SystemsCyber/CANWatermarking/provisioningApp/SelectProvisionButton.png

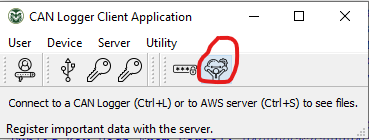
provisioningApp/SelectProvisionButton.png
