SystemsCyber/CANWatermarking/docs/SettingsExperiment.xlsx

CMAC Performance Results |  |  |  |  |  |  |  | CMAC_SEND_TIME_MS 1000
Run | False Positives 0x00 | False Positives 0x0B | Count 0x00 | Count 0x0B |  | Busload | CANGEN gap | CMAC_PAD_TIME | MIN_CAN_TIME_SPACING | NUM_TX_MAILBOXES | NUM_RX_MAILBOXES | FIFO_ENABLED | SEND_DURING_PAUSE | msg.seq = 1 | Notes
1 | 146 |  |  |  |  | 27 | off | 500 | 800 | 32 | 32 | 1 | 0
2 | None |  |  |  |  | 19 | off | 500 | 1000 | 1 | 32 | 1 | 1
3 | 1 |  | 727 |  | 13.75515818 | 19 | off | 500 | 1000 | 2 | 32 | 1 | 1
4 | 1 |  | 291 |  | 34.36426117 | 20 | off | 500 | 1000 | 2 | 32 | 1 | 1
5 | 1 |  | 143 |  | 69.93006993 | 20 | off | 500 | 1000 | 2 | 32 | 0 | 1
6 | 1 |  | 2376 |  | 4.208754209 | 19 | off | 1000 | 1000 | 2 | 32 | 0 | 1
7 | 1 |  | 504 |  | 19.84126984 | 28 | off | 1000 | 500 | 2 | 32 | 1 | 1
8 | 1 |  | 114 |  | 87.71929825 | 28 | off | 500 | 1000 | 2 | 32 | 0 | 0
9 | 5 | 0 | 12965 | 13266 | 1.906141588 | 20 | off | 1000 | 1000 | 2 | 32 | 1 | 1
10 | 14 | 7 | 1529 | 1529 | 68.67233486 | 28 | off | 1000 | 500 | 2 | 32 | 1 | 1 |  | Missed one at the beginning
11 | 12 | 0 | 6821 | 6832 | 8.789277082 | 27 | off | 1000 | 800 | 2 | 32 | 1 | 1
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
