SystemsCyber/CANWatermarking/docs/Schematics for Secure Gateway Prototype.pdf

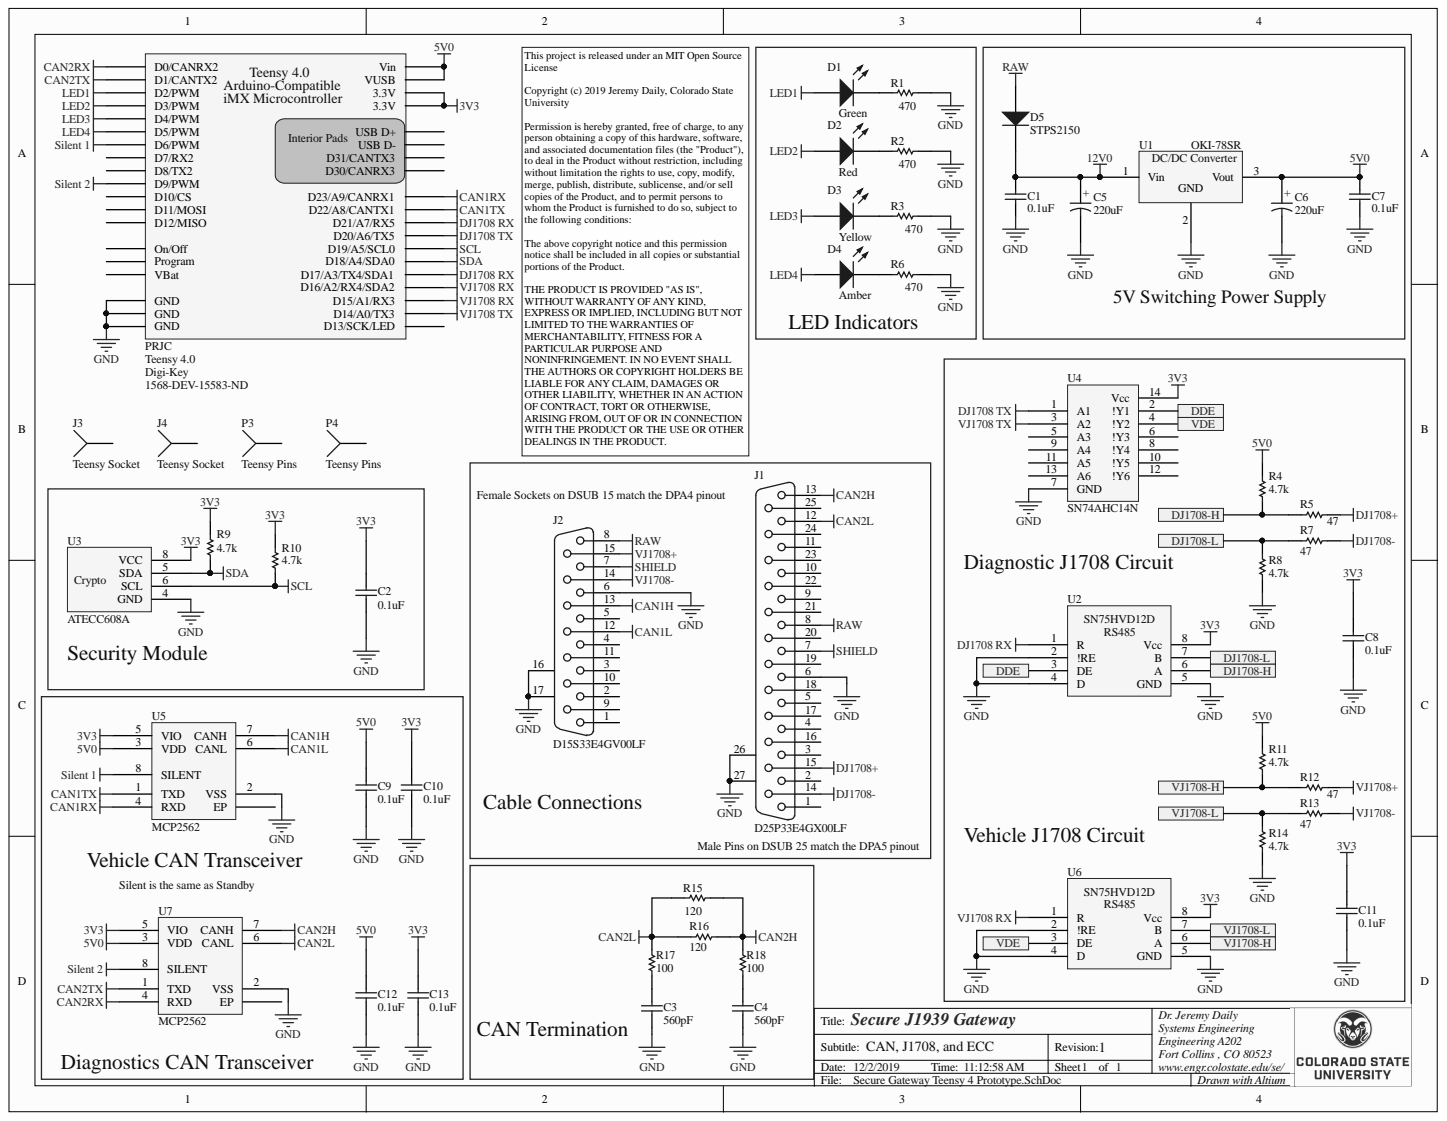
[picture p2: page 1]

This project is released under an MIT Open Source
License

Copyright (c) 2019 Jeremy Daily, Colorado State
University

Permission is hereby granted, free of charge, to any
person obtaining a copy of this hardware, software,
and associated documentation files (the "Product"),
to deal in the Product without restriction, including
without limitation the rights to use, copy, modify,
merge, publish, distribute, sublicense, and/or sell
copies of the Product, and to permit persons to
whom the Product is furnished to do so, subject to
the following conditions:

The above copyright notice and this permission
notice shall be included in all copies or substantial
portions of the Product.

THE PRODUCT IS PROVIDED "AS IS",
WITHOUT WARRANTY OF ANY KIND,
EXPRESS OR IMPLIED, INCLUDING BUT NOT
LIMITED TO THE WARRANTIES OF
MERCHANTABILITY, FITNESS FOR A
PARTICULAR PURPOSE AND
NONINFRINGEMENT. IN NO EVENT SHALL
THE AUTHORS OR COPYRIGHT HOLDERS BE
LIABLE FOR ANY CLAIM, DAMAGES OR
OTHER LIABILITY, WHETHER IN AN ACTION
OF CONTRACT, TORT OR OTHERWISE,
ARISING FROM, OUT OF OR IN CONNECTION
WITH THE PRODUCT OR THE USE OR OTHER
DEALINGS IN THE PRODUCT.

Female Sockets on DSUB 15 match the DPA4 pinout

DDE | DJ1708-H

Male Pins on DSUB 25 match the DPA5 pinout

Silent is the same as Standby

Subtitle:
Secure Gateway Teensy 4 Prototype.SchDoc

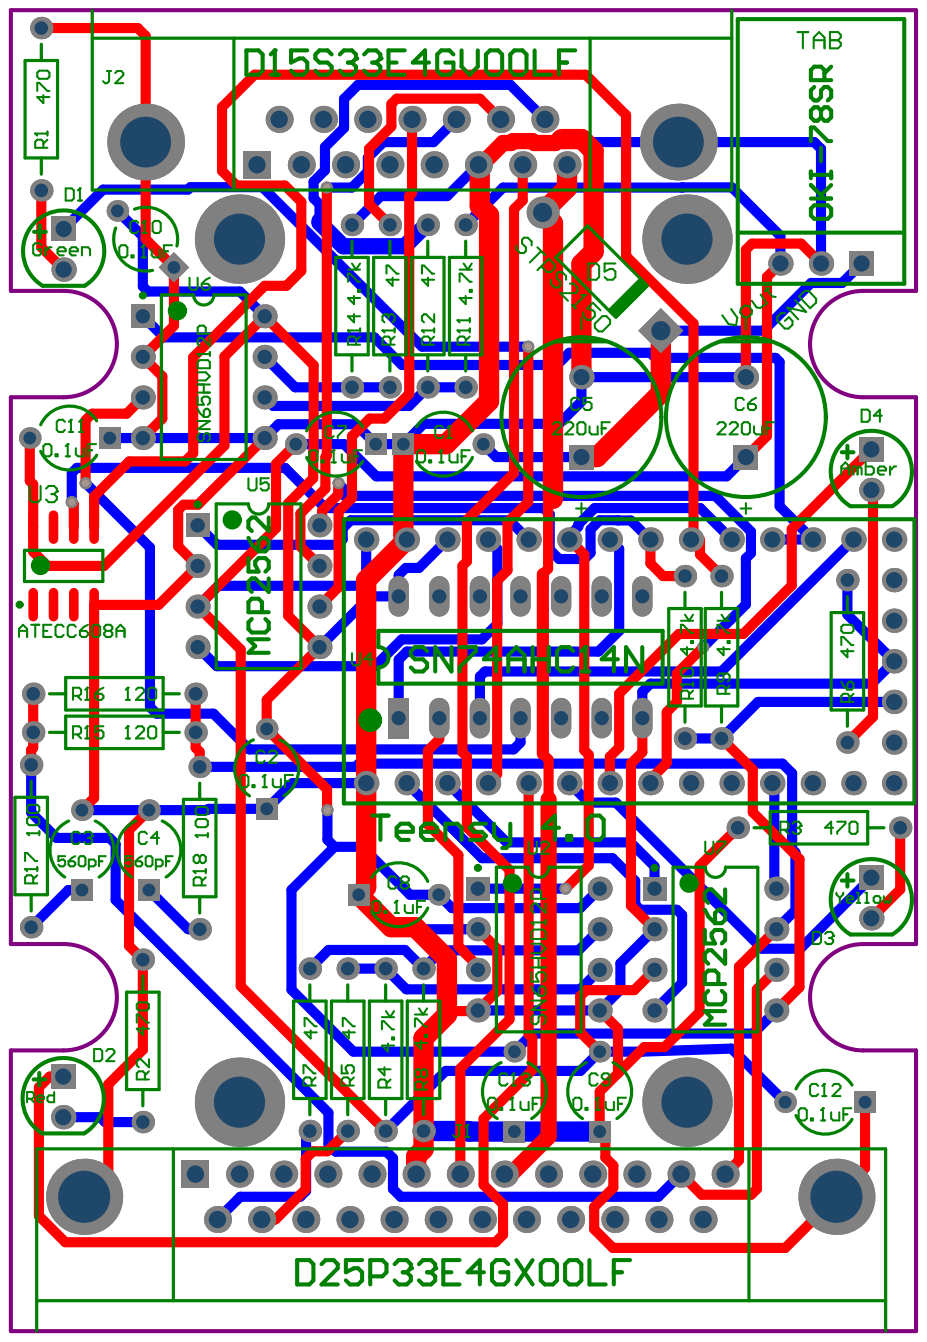
[picture p3: page 2]

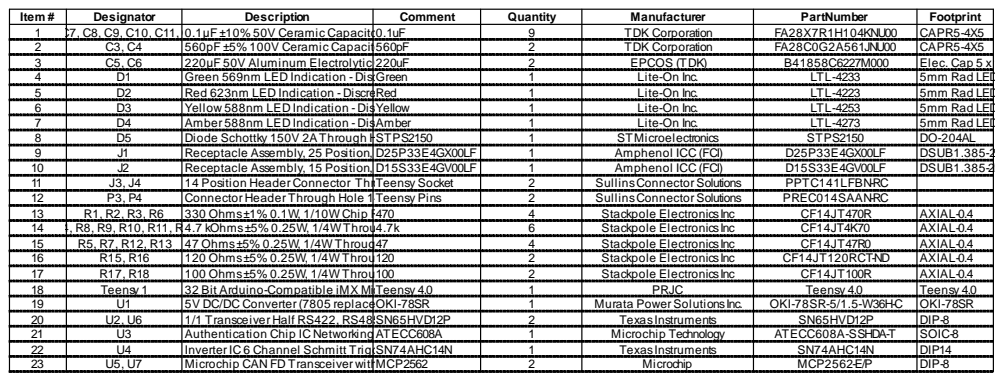
[picture p4: page 3]
