SystemsCyber/CANWatermarking/(commit log)

2020-03-20 Basic Framework To Deploy
2020-04-07 Improved Commissioning
    [ATECC Configuration.xlsx]
2020-05-04 CMACs checkout when things are just right.
    CMACs fail for some reason. I think the messages get out of order.
    [EEPROM MapBook1.xlsx]
2020-05-04 Longer CMAC Matching
    Testing with just a brake controller.
2020-05-07 Have decent success on two modules
    Still have false positives.
    [SettingsExperiment.xlsx]
2020-05-12 Reduced false positive DM1 messages
    Reset the cmac_reciept_timer for all recieved messages from the gateway so a missing source address alone will not throw a fault code.
    Also added an attacker node to test the different features of the IDS.
    [CANConditionerSketch.ino, passthrough_with_simple_attacks.ino]
2020-07-13 Updated Provisioning Sketch
    Depends on the Arduino Library
